Monotoba/j48-gal-programmer/wingman/README.md

# Wingman

Host software for the J48 Programmer: reads and writes JEDEC (.jed) files and drives the programmer over USB. Not started.

Written clean-room from `docs/spec/`; see `docs/CLEAN_ROOM.md`.
