Monotoba/j48-gal-programmer/docs/spec/16v8.md

# GAL16V8 programming specification

Covers the GAL16V8 family (Lattice GAL16V8, 16V8A/B/D and second sources) and notes where the Atmel ATF16V8B differs. Written from published sources only; see [CLEAN_ROOM.md](../CLEAN_ROOM.md). Facts carry a source tag; anything not yet sourced is listed under **Open questions**, not guessed.

## Sources

| Tag | Source |
| --- | --- |
| [D1] | Lattice Semiconductor, *GAL16V8 High Performance E²CMOS PLD* datasheet, https://www.cl.cam.ac.uk/teaching/0708/Hardware/datasheets/gal16v8.pdf |
| [G1] | GALer documentation, "Programming GALs" (§III.1), https://k1.spdns.de/Develop/Projects/GalAsm/info/galer/proggal.html |
| [G2] | GALer documentation, "The GAL16V8 and GAL20V8", https://k1.spdns.de/Develop/Projects/GalAsm/info/galer/gal16_20v8.html |
| [G3] | GALer documentation, "JEDEC File", https://k1.spdns.de/Develop/Projects/GalAsm/info/galer/jedecfile.html |
| [A1] | Bruce Abbott, "Parallel Port ATF and GAL Programmer" (project page, prose only), https://www.bhabbott.net.nz/atfblast.html |
| [J] | [jedec.md](jedec.md) for the JEDEC file format and checksum |

## Device summary

- 20-pin device: pins 2–9 inputs, pin 1 input or clock, pin 11 input or /OE, pins 12–19 output cells (OLMCs), pin 10 GND, pin 20 VCC. [G2]
- AND array of 64 product terms × 32 input lines = 2,048 fuses. Each OLMC owns 8 product terms (a 256-fuse block); the 8th can serve as the output-enable term. [D1]
- Operating modes, set by SYN, AC0 and each OLMC's AC1 (XOR sets polarity: 0 = active low, 1 = active high): [D1][G2]

| Mode | SYN | AC0 | AC1(n) = 0 | AC1(n) = 1 |
| --- | --- | --- | --- | --- |
| Simple | 1 | 0 | combinational output | dedicated input |
| Complex | 1 | 1 | — | combinational I/O (tristate) |
| Registered | 0 | 1 | registered output | combinational I/O |

- Endurance 100 erase/write cycles, data retention 20 years, erase time under 100 ms. [D1]

## JEDEC fuse map (QF2194)

| Fuses | Contents | Source |
| --- | --- | --- |
| 0–2047 | AND array: product term *n* starts at fuse 32 × *n* | [D1][G3] |
| 2048–2055 | XOR bits, one per OLMC | [D1][G3] |
| 2056–2119 | User Electronic Signature (UES), 64 bits | [G3] |
| 2120–2127 | AC1 bits, one per OLMC | [D1][G3] |
| 2128–2191 | Product-term disable (PTD) bits, one per product term | [D1][G3] |
| 2192 | SYN | [D1][G3] |
| 2193 | AC0 | [D1][G3] |

The UES is readable even when the security cell is set, and it is included in the checksum. [D1]

## Programming-mode pins

The device enters edit mode when 12.00–16.5 V is applied to pin 2 (EDIT), with VCC at 5 V. Pins not listed must be held low. [G1]

| Chip pin | Role | Notes | ZIF-28 | J48 Rev H net (driver) |
| --- | --- | --- | --- | --- |
| 2 | EDIT | edit-mode supply | 2 | VPP (VPP generator) |
| 3 | RA1 | row address | 3 | U1 PD0 (MCU) |
| 4 | RA2 | row address | 4 | U2 Q0 (595) |
| 5 | RA3 | row address | 5 | U2 Q3 (595) |
| 6 | RA4 | row address | 6 | U2 Q2 (595) |
| 7 | RA5 | row address | 7 | U2 Q1 via R43 (595) |
| 8 | SCLK | serial clock, data shifts on the rising edge | 8 | U1 PD2 (MCU) |
| 9 | SDIN | serial data in | 9 | U1 PD3 (MCU) |
| 10 | GND | | 10 | Q1 ground switch |
| 11 | /STR | strobe, active low | 19 | U1 PC3 (MCU) |
| 12 | SDOUT | serial data out | 20 | U1 PF0 (MCU) |
| 18 | RA0 | row address | 26 | U1 PF1 (MCU) |
| 19 | P/V | high = program (write), low = verify (read) | 27 | U2 Q7 (595) |
| 20 | VCC | 5 V | 28 | Q6 VCC switch |
| 1, 13–17 | held low | | 1, 21–25 | pull-downs (1, 21–23); U2 Q5, Q4 driven low (24, 25) |

Pin roles from [G1]; the same roles appear in the Afterburner pin map, an independent source. ZIF and net columns are J48 Rev H (`hardware/drawings/J48_ZIF28_Pin_Map_RevH.pdf`).

## Row map

Rows are selected with RA0–RA5 (row 0–63). [G1]

| Row | Width | Contents | Source |
| --- | --- | --- | --- |
| 0–31 | 64 bits | AND-array fuses | [G1] |
| 32 | 64 bits | User Electronic Signature | [G1] |
| 33–59 | 64 bits | reserved | [G1] |
| 60 | 82 bits | Architecture Control Word (ACW) | [G1] |
| 61 | — | security bit | [G1] |
| 62 | — | reserved | [G1] |
| 63 | — | bulk erase | [G1] |

**ACW bit order (row 60), GAL16V8A/B:** bits 0–3 XOR, bit 4 AC0, bits 5–8 AC1, bits 9–72 PT0–PT63 (product-term enables), bits 73–76 AC1, bit 77 SYN, bits 78–81 XOR. The original GAL16V8 (no suffix) uses a different order. [G1]

## Sequences

**Read a row:** set P/V low; put the row address on RA0–RA5; pulse /STR low to load the row into the device's shift register; then give one rising edge on SCLK per bit, reading SDOUT for each. [G1]

**Write a row:** set P/V high; put the row address on RA0–RA5; shift the row's bits in on SDIN, one rising SCLK edge per bit; pulse /STR low for the programming pulse width (table below). [G1]

**Bulk erase:** set P/V high, select row 63, pulse /STR low for 100 ms, then set P/V low. [G1]

**Programming flow (J48):**
1. With the socket unpowered, select the 20-pin configuration: Q1 (ZIF 10 GND) and Q6 (ZIF 28 VCC). See the Rev H switch table.
2. Apply VCC, hold all non-programming pins low, then raise EDIT to the read level.
3. Identify the device and its algorithm (see Open questions), then bulk erase at the programming level.
4. Write rows 0–31, the UES (row 32) and the ACW (row 60) at the programming level and pulse width.
5. Drop to the read level and read every row back to verify.
6. If the JEDEC file has `G1`, set the security bit (row 61).
7. Lower EDIT to 0 V before removing VCC.

## Voltages and pulse widths by algorithm

| Algorithm | Read EDIT level | Read /STR pulse | Program EDIT level | Program /STR pulse |
| --- | --- | --- | --- | --- |
| 0 | 12.00 ± 0.25 V | 5 µs | 15.75 ± 0.25 V | 80 ± 5 ms |
| 1 | 12.00 ± 0.25 V | 5 µs | 15.75 ± 0.25 V | 80 ± 5 ms |
| 2 | 12.00 ± 0.25 V | 5 µs | 16.50 ± 0.25 V | 10 ± 1 ms |
| 3 | 12.00 ± 0.25 V | 5 µs | 14.50 ± 0.25 V | 40 ± 5 ms |
| 4 | 12.00 ± 0.25 V | 5 µs | 14.00 ± 0.25 V | 100 ± 5 ms |

Source: [G1]. The J48's VPP generator covers this range: 0–17.4 V, about 4.25 mV per DAC step.

## Atmel ATF16V8B differences

- The ATF electronic signature does not encode programming parameters; it holds the part number as byte-reversed text (for example "1F16V8B1" for an ATF16V8B). Interpreting it as a GAL signature selects the wrong algorithm. [A1]
- Atmel parts should be conditioned before programming: program all cells to 0 twice, then erase. Verify errors during conditioning can be ignored. [A1]
- ATF parts have input pull-ups or pin keepers; most Lattice GAL16V8/16V8B parts do not. [A1]
- Programming voltage requirement for ATF parts: see Open questions.

## Open questions

Each needs a published source before firmware depends on it.

- [ ] **Signature row and algorithm code:** which row holds the programmer electronic signature (PES), its width, and how its bytes encode manufacturer, algorithm, EDIT voltage and pulse width.
- [ ] **Row-to-fuse mapping:** how programming rows 0–31 (64 bits each) map onto the JEDEC array (64 product terms × 32 inputs), including whether the input-line order is linear.
- [ ] **Bit order:** which bit is shifted first when writing and reading a row, and how ACW bits map onto JEDEC fuses 2048–2193.
- [ ] **Original GAL16V8 ACW order** (no-suffix parts), which [G1] says differs from the A/B order.
- [ ] **Security bit (row 61):** the exact write sequence.
- [ ] **Timing:** SCLK high/low times, setup and hold of SDIN and RA lines, settling time after changing EDIT level, delay after /STR before reading.
- [ ] **ATF16V8B:** its programming EDIT voltage, pulse widths and erase sequence.
- [ ] **JEDEC checksum detail:** see [jedec.md](jedec.md).
