Monotoba/j48-gal-programmer/docs/pin-map/J48_RevH_ZIF28_Plan.xlsx

Sheet: 26CV12 Changes
GAL26CV12 / 26V12 head-aligned in a ZIF-28: what each position needs (proposed Rev H)
Shaded rows need hardware changes. ZIF numbers are for the proposed ZIF-28; Rev G ZIF 13–24 become ZIF 17–28.
ZIF (Rev H) | 26CV12 needs | Rev G has there | Change
2 | EDIT (VPP) | VPP | None
3 | PV | U1 PD0 | None
4, 5, 6 | RA0–RA2 | U2 Q0, Q3, Q2 | None
7 | VCC | U2 Q1 (RA3 for 22V10) | High-side P-FET from VCC_SKT, plus 100 Ω in series with U2 Q1
8 | Low | U1 PD2 | None
9, 10, 11 | RA3–RA5 | U1 PD3, PD4, PD5 | None
12 | SCLK | Hard GND (24-pin GND) | Ground-switch FET for 24-pin parts, plus a driver through 100 Ω
13, 14 | SDIN, STB | New position | Drivers
15 | SDOUT | New position | Must be an MCU input
16–20 | Low | New pull-down, then MCU lines | None (firmware drives them low)
21 | GND | Pull-down only | Ground-switch FET
22–27 | Low | Pull-downs, 595, MCU | None
28 | Low | VCC_SKT, always on | High-side P-FET for 20/24-pin parts, plus a pull-down
Source: 26CV12 programming pinout from the EMDP1 GAL28 plug table, gramlich.net/projects/extensible_programmer/emdp1/plugs/gal28/rev_a/ (cross-check against Afterburner's 26CV12 adapter files).

Sheet: ZIF-28 Map
ZIF-28 socket map, all devices head-aligned (proposed Rev H)
Orange rows change in Rev H; green rows are new socket positions. Chip-pin columns are formulas from the ZIF number (head alignment).
ZIF (Rev H) | Side | Rev G ZIF | Rev G connection | Rev H connection | Changed? | 20-pin chip pin | 16V8 | 18V10 | 24-pin chip pin | 22V10 / 20XV10 / ATF750C | 20V8 | 6001 / 6002 | JTAG ATF150x | 28-pin chip pin | 26CV12 / 26V12
1 | left (1–14) | 1 | Pull-down R20 10k | Pull-down R20 10k (unchanged) | No | 1 | - | - | 1 | - | - | - | - | 1 | low
2 | left (1–14) | 2 | VPP | VPP (unchanged) | No | 2 | EDIT | EDIT | 2 | EDIT | EDIT | EDIT | EDIT | 2 | EDIT
3 | left (1–14) | 3 | U1 PD0 (via R2) | U1 PD0 (via R2) (unchanged) | No | 3 | RA1 | RA3 | 3 | PV | RA1 | - | TDI | 3 | PV
4 | left (1–14) | 4 | U2 Q0 | U2 Q0 (unchanged) | No | 4 | RA2 | RA4 | 4 | RA0 | RA2 | RA0 | - | 4 | RA0
5 | left (1–14) | 5 | U2 Q3 | U2 Q3 (unchanged) | No | 5 | RA3 | RA5 | 5 | RA1 | RA3 | RA1 | - | 5 | RA1
6 | left (1–14) | 6 | U2 Q2 | U2 Q2 (unchanged) | No | 6 | RA4 | SCLK | 6 | RA2 | - | RA2 | - | 6 | RA2
7 | left (1–14) | 7 | U2 Q1 | U2 Q1 via new 100 Ω + Q7 P-FET from VCC_SKT (VCC for 28-pin) | Yes | 7 | RA5 | DIN | 7 | RA3 | - | RA3 | - | 7 | VCC
8 | left (1–14) | 8 | U1 PD2 (via R3) | U1 PD2 (via R3) (unchanged) | No | 8 | SCLK | STR | 8 | RA4 | RA4 | RA4 | - | 8 | low
9 | left (1–14) | 9 | U1 PD3 (via R4) | U1 PD3 (via R4) (unchanged) | No | 9 | DIN | DOUT | 9 | RA5 | RA5 | RA5 | - | 9 | RA3
10 | left (1–14) | 10 | U1 PD4 (via R5) + Q1 ground switch | U1 PD4 (via R5) + Q1 ground switch (unchanged) | No | 10 | GND | GND | 10 | SCLK | SCLK | SCLK | - | 10 | RA4
11 | left (1–14) | 11 | U1 PD5 (via R6) | U1 PD5 (via R6) (unchanged) | No | — | (no chip pin) | (no chip pin) | 11 | DIN | DIN | DIN | - | 11 | RA5
12 | left (1–14) | 12 | GND (hard) | U9 Q0 via 100 Ω (SCLK) + Q4 ground switch (GND for 24-pin) | Yes | — | (no chip pin) | (no chip pin) | 12 | GND | GND | GND | GND | 12 | SCLK
13 | left (1–14) | new | — (new position) | U9 Q1 (SDIN) | Yes | — | (no chip pin) | (no chip pin) | — | (no chip pin) | (no chip pin) | (no chip pin) | (no chip pin) | 13 | SDIN
14 | left (1–14) | new | — (new position) | U9 Q2 (STB) | Yes | — | (no chip pin) | (no chip pin) | — | (no chip pin) | (no chip pin) | (no chip pin) | (no chip pin) | 14 | STB
15 | right (15–28) | new | — (new position) | U1 PA3 via 100 Ω (SDOUT); PA3 was BOOST_EN | Yes | — | (no chip pin) | (no chip pin) | — | (no chip pin) | (no chip pin) | (no chip pin) | (no chip pin) | 15 | SDOUT
16 | right (15–28) | new | — (new position) | Pull-down 10k (new) | Yes | — | (no chip pin) | (no chip pin) | — | (no chip pin) | (no chip pin) | (no chip pin) | (no chip pin) | 16 | low
17 | right (15–28) | 13 | U1 PD6 (via R7) | U1 PD6 (via R7) (unchanged) | No | — | (no chip pin) | (no chip pin) | 13 | STR | STR | STR | TMS | 17 | low
18 | right (15–28) | 14 | U1 PD7 (via R8) | U1 PD7 (via R8) (unchanged) | No | — | (no chip pin) | (no chip pin) | 14 | DOUT | - | DOUT | - | 18 | low
19 | right (15–28) | 15 | U1 PC3 (via R1) | U1 PC3 (via R1) (unchanged) | No | 11 | STR | - | 15 | - | DOUT | - | - | 19 | low
20 | right (15–28) | 16 | U1 PF0 (via R9) | U1 PF0 (via R9) (unchanged) | No | 12 | DOUT | - | 16 | - | - | - | - | 20 | low
21 | right (15–28) | 17 | Pull-down R21 10k | Pull-down R21 10k + Q5 ground switch (GND for 28-pin) | Yes | 13 | - | - | 17 | - | - | - | - | 21 | GND
22 | right (15–28) | 18 | Pull-down R22 10k | Pull-down R22 10k (unchanged) | No | 14 | - | - | 18 | - | - | - | - | 22 | low
23 | right (15–28) | 19 | Pull-down R23 10k | Pull-down R23 10k (unchanged) | No | 15 | - | - | 19 | - | - | - | - | 23 | low
24 | right (15–28) | 20 | U2 Q5 | U2 Q5 (unchanged) | No | 16 | - | RA2 | 20 | - | - | - | - | 24 | low
25 | right (15–28) | 21 | U2 Q4 | U2 Q4 (unchanged) | No | 17 | - | RA1 | 21 | - | RA0 | - | - | 25 | low
26 | right (15–28) | 22 | U1 PF1 (via R10) | U1 PF1 (via R10) (unchanged) | No | 18 | RA0 | RA0 | 22 | - | PV | - | TDO | 26 | low
27 | right (15–28) | 23 | U2 Q7 | U2 Q7 (unchanged) | No | 19 | PV | PV | 23 | - | - | PV | TCK | 27 | low
28 | right (15–28) | 24 | VCC_SKT (always on) | VCC_SKT via Q6 P-FET (VCC for 20/24-pin) + pull-down 10k | Yes | 20 | VCC | VCC | 24 | VCC | VCC | VCC | VCC | 28 | low
Role names: EDIT = VPP pin in edit mode, PV = program/verify, RA0–RA5 = row address, SCLK = serial clock, DIN/SDIN = serial data in,
STR/STB = strobe, DOUT/SDOUT = serial data out, '-' / 'low' = held low or undriven. Afterburner names are used for the 20/24-pin columns.
Source: Afterburner rev 3.2b schematic, 'ZIF SOCKET PIN MAP' (ole00), as uploaded.
Source: 26CV12 programming pinout from the EMDP1 GAL28 plug table, gramlich.net/projects/extensible_programmer/emdp1/plugs/gal28/rev_a/ (cross-check against Afterburner's 26CV12 adapter files).
Positions changed in Rev H |  |  |  | 8
New positions (no Rev G equivalent) |  |  |  | 4

Sheet: U9 595 Outputs
U9: second 74HC595, chained from U2 Q7' (proposed Rev H)
U9 shares SPI_SCK, SR_RCLK and SR_OE with U2; its SER (pin 14) comes from U2 Q7' (pin 9). Each update shifts 2 bytes, U9 first.
Output | U9 pin | Net | Drives | Used for | Active level | State at reset
Q0 | 15 | ZIF12_SCLK | ZIF 12 via 100 Ω | 26CV12 SCLK; held low in 24-pin mode (Q4 grounds ZIF 12) | High = 1 | Hi-Z (/OE high)
Q1 | 1 | ZIF13_SDIN | ZIF 13 | 26CV12 SDIN | High = 1 | Hi-Z (/OE high)
Q2 | 2 | ZIF14_STB | ZIF 14 | 26CV12 STB (active low) | High = 1 | Hi-Z (/OE high)
Q3 | 3 | BOOST_EN | U4 EN (was U1 PA3) | Boost on; R36 pull-down keeps it off at reset | High = on | Off (R36)
Q4 | 4 | GND12_EN | Q4 gate (N-FET, ZIF 12 to GND) | 24-pin parts only | High = grounded | Off (gate pull-down)
Q5 | 5 | GND21_EN | Q5 gate (N-FET, ZIF 21 to GND) | 28-pin parts only | High = grounded | Off (gate pull-down)
Q6 | 6 | VCC28_EN | Q6 gate (P-FET, VCC_SKT to ZIF 28) | 20- and 24-pin parts | Low = VCC on | Off (gate pull-up)
Q7 | 7 | VCC7_EN | Q7 gate (P-FET, VCC_SKT to ZIF 7) | 28-pin parts only | Low = VCC on | Off (gate pull-up)
Q7' | 9 | — | Not connected | End of chain | — | —
Freed MCU pin |  | U1 PA3 (pin 1): was BOOST_EN, becomes SDOUT input from ZIF 15 via 100 Ω.
Note |  | SCLK and SDIN through a 595 cost a few µs per bit; the 26CV12's ~10 ms per-row programming pulse dominates.

Sheet: Socket Power Modes
Ground and VCC switch settings by device size (proposed Rev H)
Firmware interlock: exactly one GND switch and one VCC switch on at a time, chosen by device size. Never Q6 with Q7, never Q4 with a 28-pin part.
Device size | Q1: ZIF 10 GND (595 U2 Q6) | Q4: ZIF 12 GND (U9 Q4) | Q5: ZIF 21 GND (U9 Q5) | Q6: ZIF 28 VCC (U9 Q6) | Q7: ZIF 7 VCC (U9 Q7) | Notes | GND switches on | VCC switches on
No device / reset | Off | Off | Off | Off | Off | All outputs Hi-Z; socket unpowered until firmware selects a size | 0 | 0
20-pin (16V8, 18V10) | On | Off | Off | On | Off | Chip GND on ZIF 10, VCC on ZIF 28 | 1 | 1
24-pin (22V10, 20V8, 6001/6002, ATF750C, JTAG adapter) | Off | On | Off | On | Off | Chip GND on ZIF 12, VCC on ZIF 28; U9 Q0 must be low | 1 | 1
28-pin (26CV12, 26V12) | Off | Off | On | Off | On | Chip GND on ZIF 21, VCC on ZIF 7; ZIF 28 held low by its pull-down; U2 Q1 set high | 1 | 1

Sheet: Rev H Parts
Rev H parts added or changed (proposed)
Reference designators continue from Rev G (last: Q3, R36, C18, U8, J4). Values are proposals to confirm.
Ref | Part / value | Qty | Purpose | Add / change
J1 | ZIF-28 socket, accepts 0.3" and 0.6" DIP | 1 | Replaces the ZIF-24 | Change
U9 | 74HC595 | 1 | Second shift register, chained from U2 Q7' | Add
C19 | 100n | 1 | U9 decoupling, VSYS | Add
Q4, Q5 | AO3400 N-FET (logic level) | 2 | Ground switches on ZIF 12 and ZIF 21 | Add
Q6, Q7 | AO3401 P-FET (logic level) | 2 | VCC switches on ZIF 28 and ZIF 7 | Add
R37, R38 | 100 Ω | 2 | Gate resistors for Q4, Q5 | Add
R39, R40 | 100k | 2 | Gate pull-downs for Q4, Q5 (off at reset) | Add
R41, R42 | 100k | 2 | Gate pull-ups to VCC_SKT for Q6, Q7 (off at reset) | Add
R43 | 100 Ω | 1 | U2 Q1 to ZIF 7 series resistor | Add
R44 | 100 Ω | 1 | U9 Q0 to ZIF 12 series resistor | Add
R45 | 100 Ω | 1 | U1 PA3 to ZIF 15 series resistor | Add
R46, R47 | 10k | 2 | Pull-downs on ZIF 16 and ZIF 28 | Add
 | Total parts | 18
 | Resistors added | 11

Sheet: Notes
Behaviour changes and open items (proposed Rev H)
Socket powers up dead | With U9's outputs off at reset, every VCC and GND switch is off. Firmware selects the device size before the chip gets power. 24-pin parts now need firmware to ground ZIF 12 (it was hard ground in Rev G).
Interlocks | Never turn on the ZIF 7 and ZIF 28 supplies together, and never ground ZIF 12 with a 28-pin part in the socket: those contacts carry signals for the other sizes.
Existing devices | Rev G ZIF 13–24 wiring keeps its nets and moves to ZIF 17–28, so 20- and 24-pin parts and the JTAG adapter see the same signals as before.
Firmware | The 26CV12 algorithm is close to the 22V10's with a different fuse-map geometry. Afterburner supports GAL26CV12B and GAL26V12C through an adapter, so this is a port.
Verify pinout | Cross-check the 26CV12 programming pinout against Afterburner's 26CV12 adapter files before committing (VCC pin 7, GND pin 21).
Socket width | The 26CV12 DIP is the 0.3" skinny package: choose a ZIF-28 that takes both 0.3" and 0.6" parts.
Speed | SCLK and SDIN through U9 cost a few µs per bit, small next to the ~10 ms per-row programming pulse. Rev F already clocks the 18V10 through a 595 (ZIF 6).
Sources | Source: Afterburner rev 3.2b schematic, 'ZIF SOCKET PIN MAP' (ole00), as uploaded. Source: 26CV12 programming pinout from the EMDP1 GAL28 plug table, gramlich.net/projects/extensible_programmer/emdp1/plugs/gal28/rev_a/ (cross-check against Afterburner's 26CV12 adapter files). Afterburner supported-chip list: github.com/ole00/afterburner.
