Monotoba/j48-gal-programmer/hardware/kicad/J48_RevI.kicad_sch

## KiCad design hardware/kicad/J48_RevI.kicad_sch (2026-10-22)

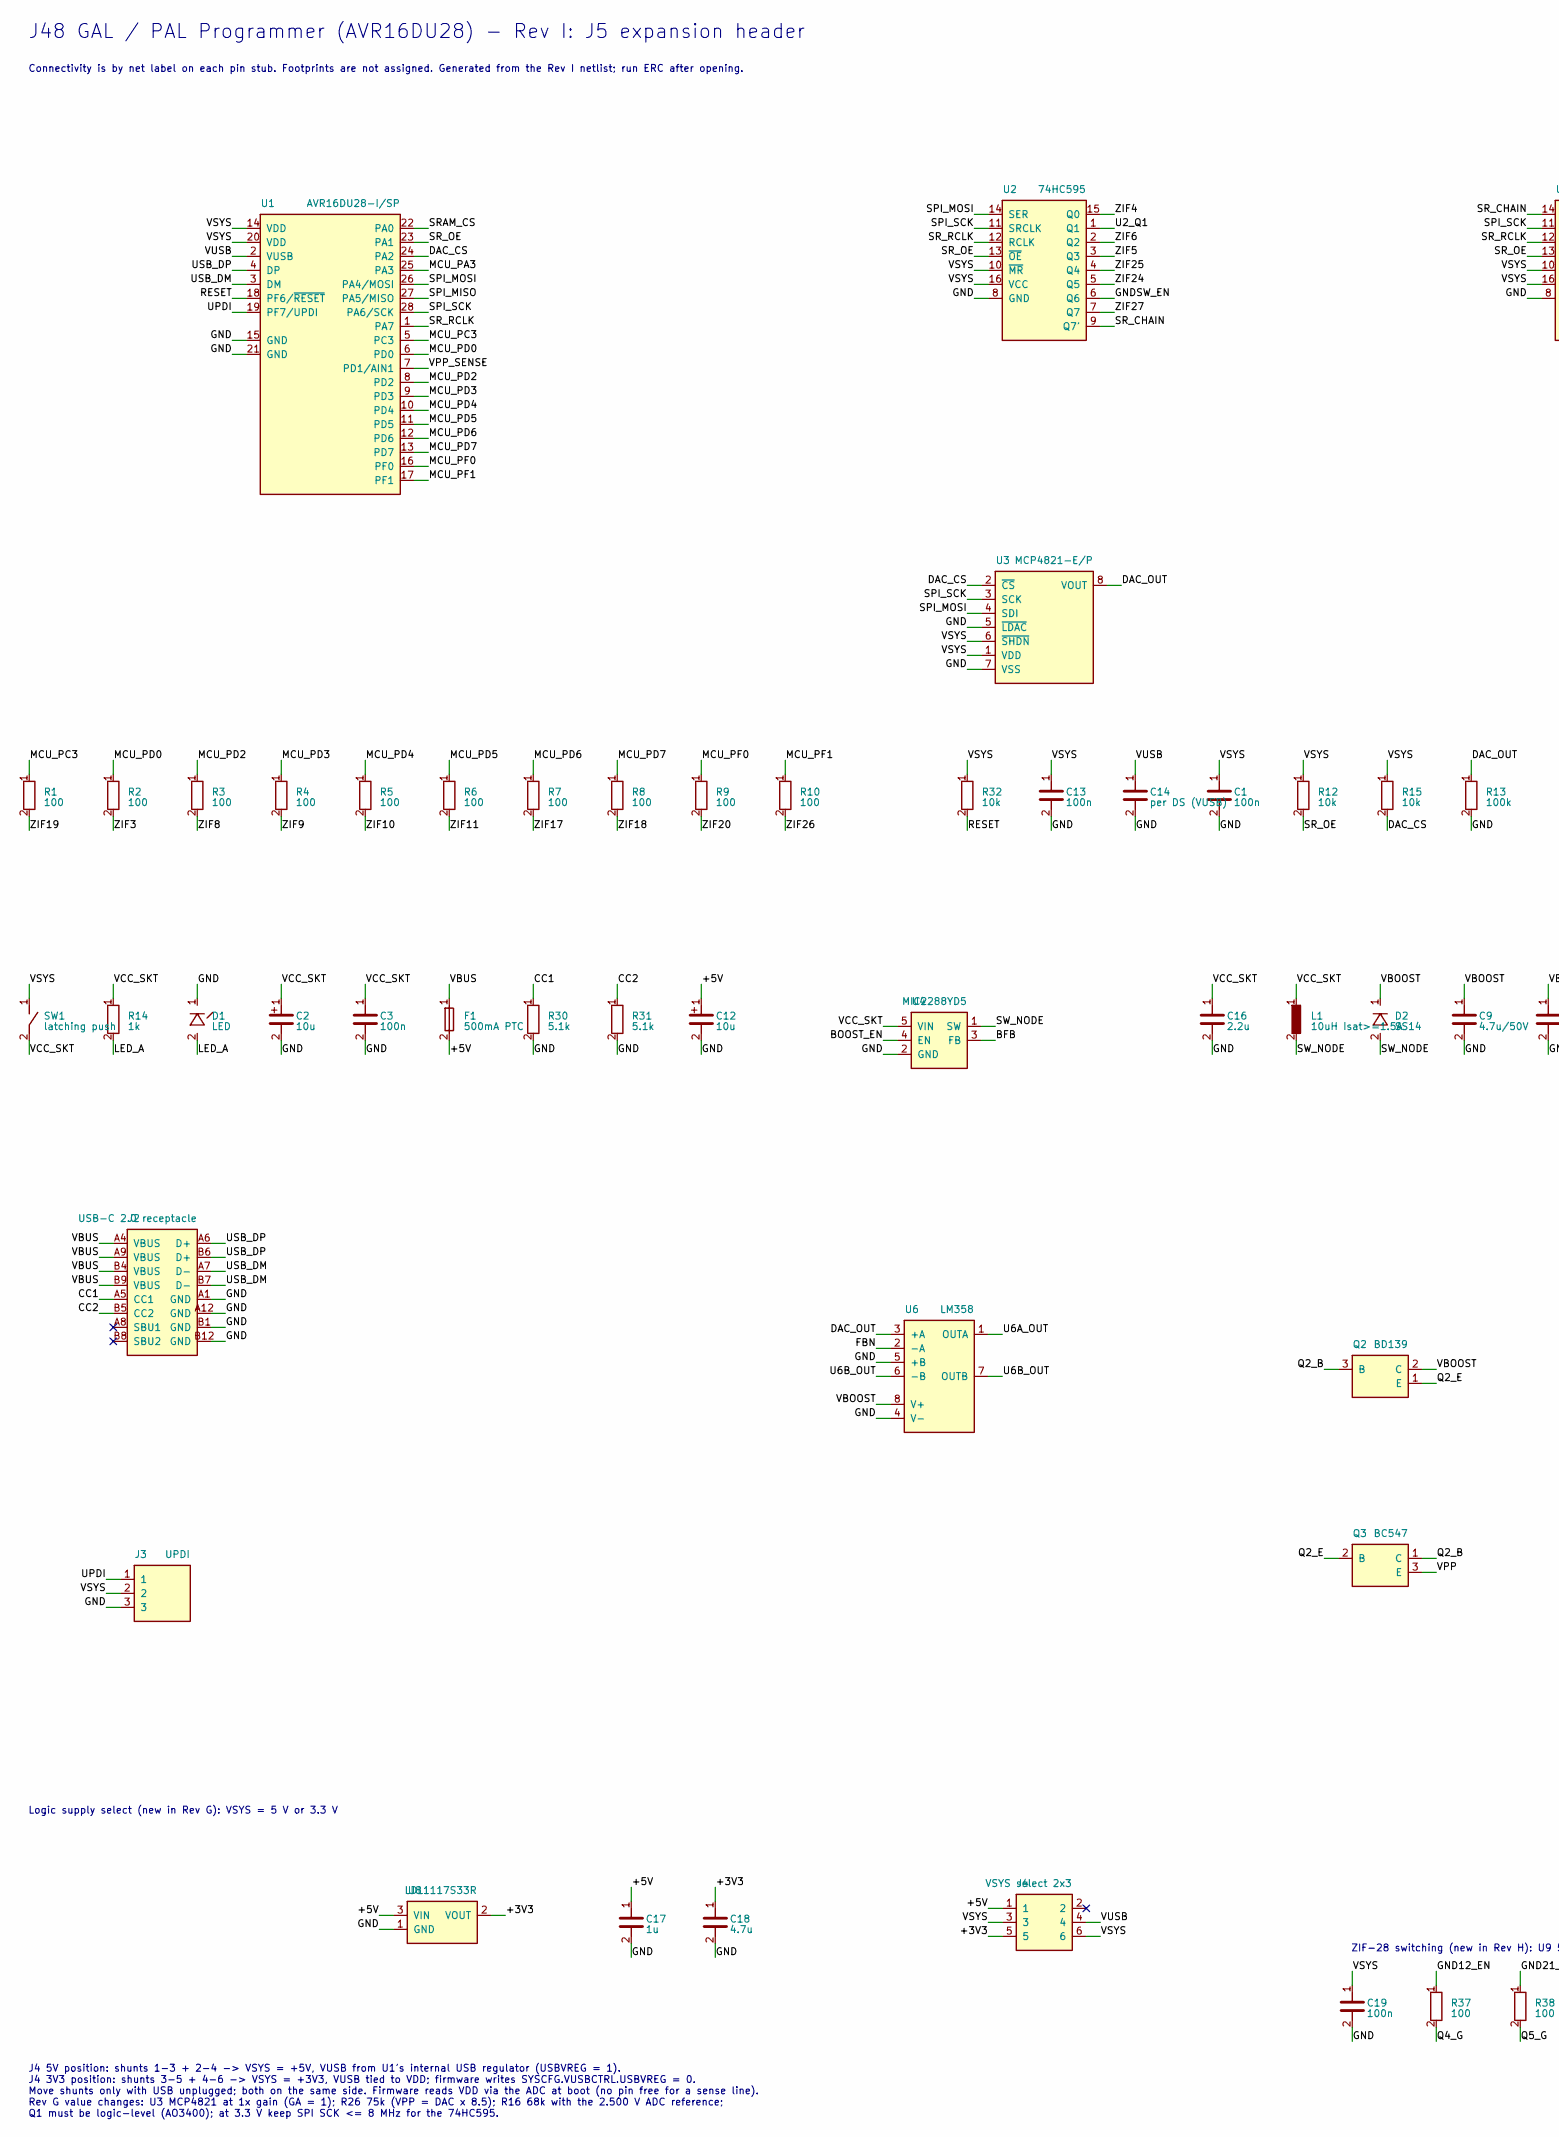
[picture p6: schematic J48_RevI.kicad_sch, part in row 1, column 1]

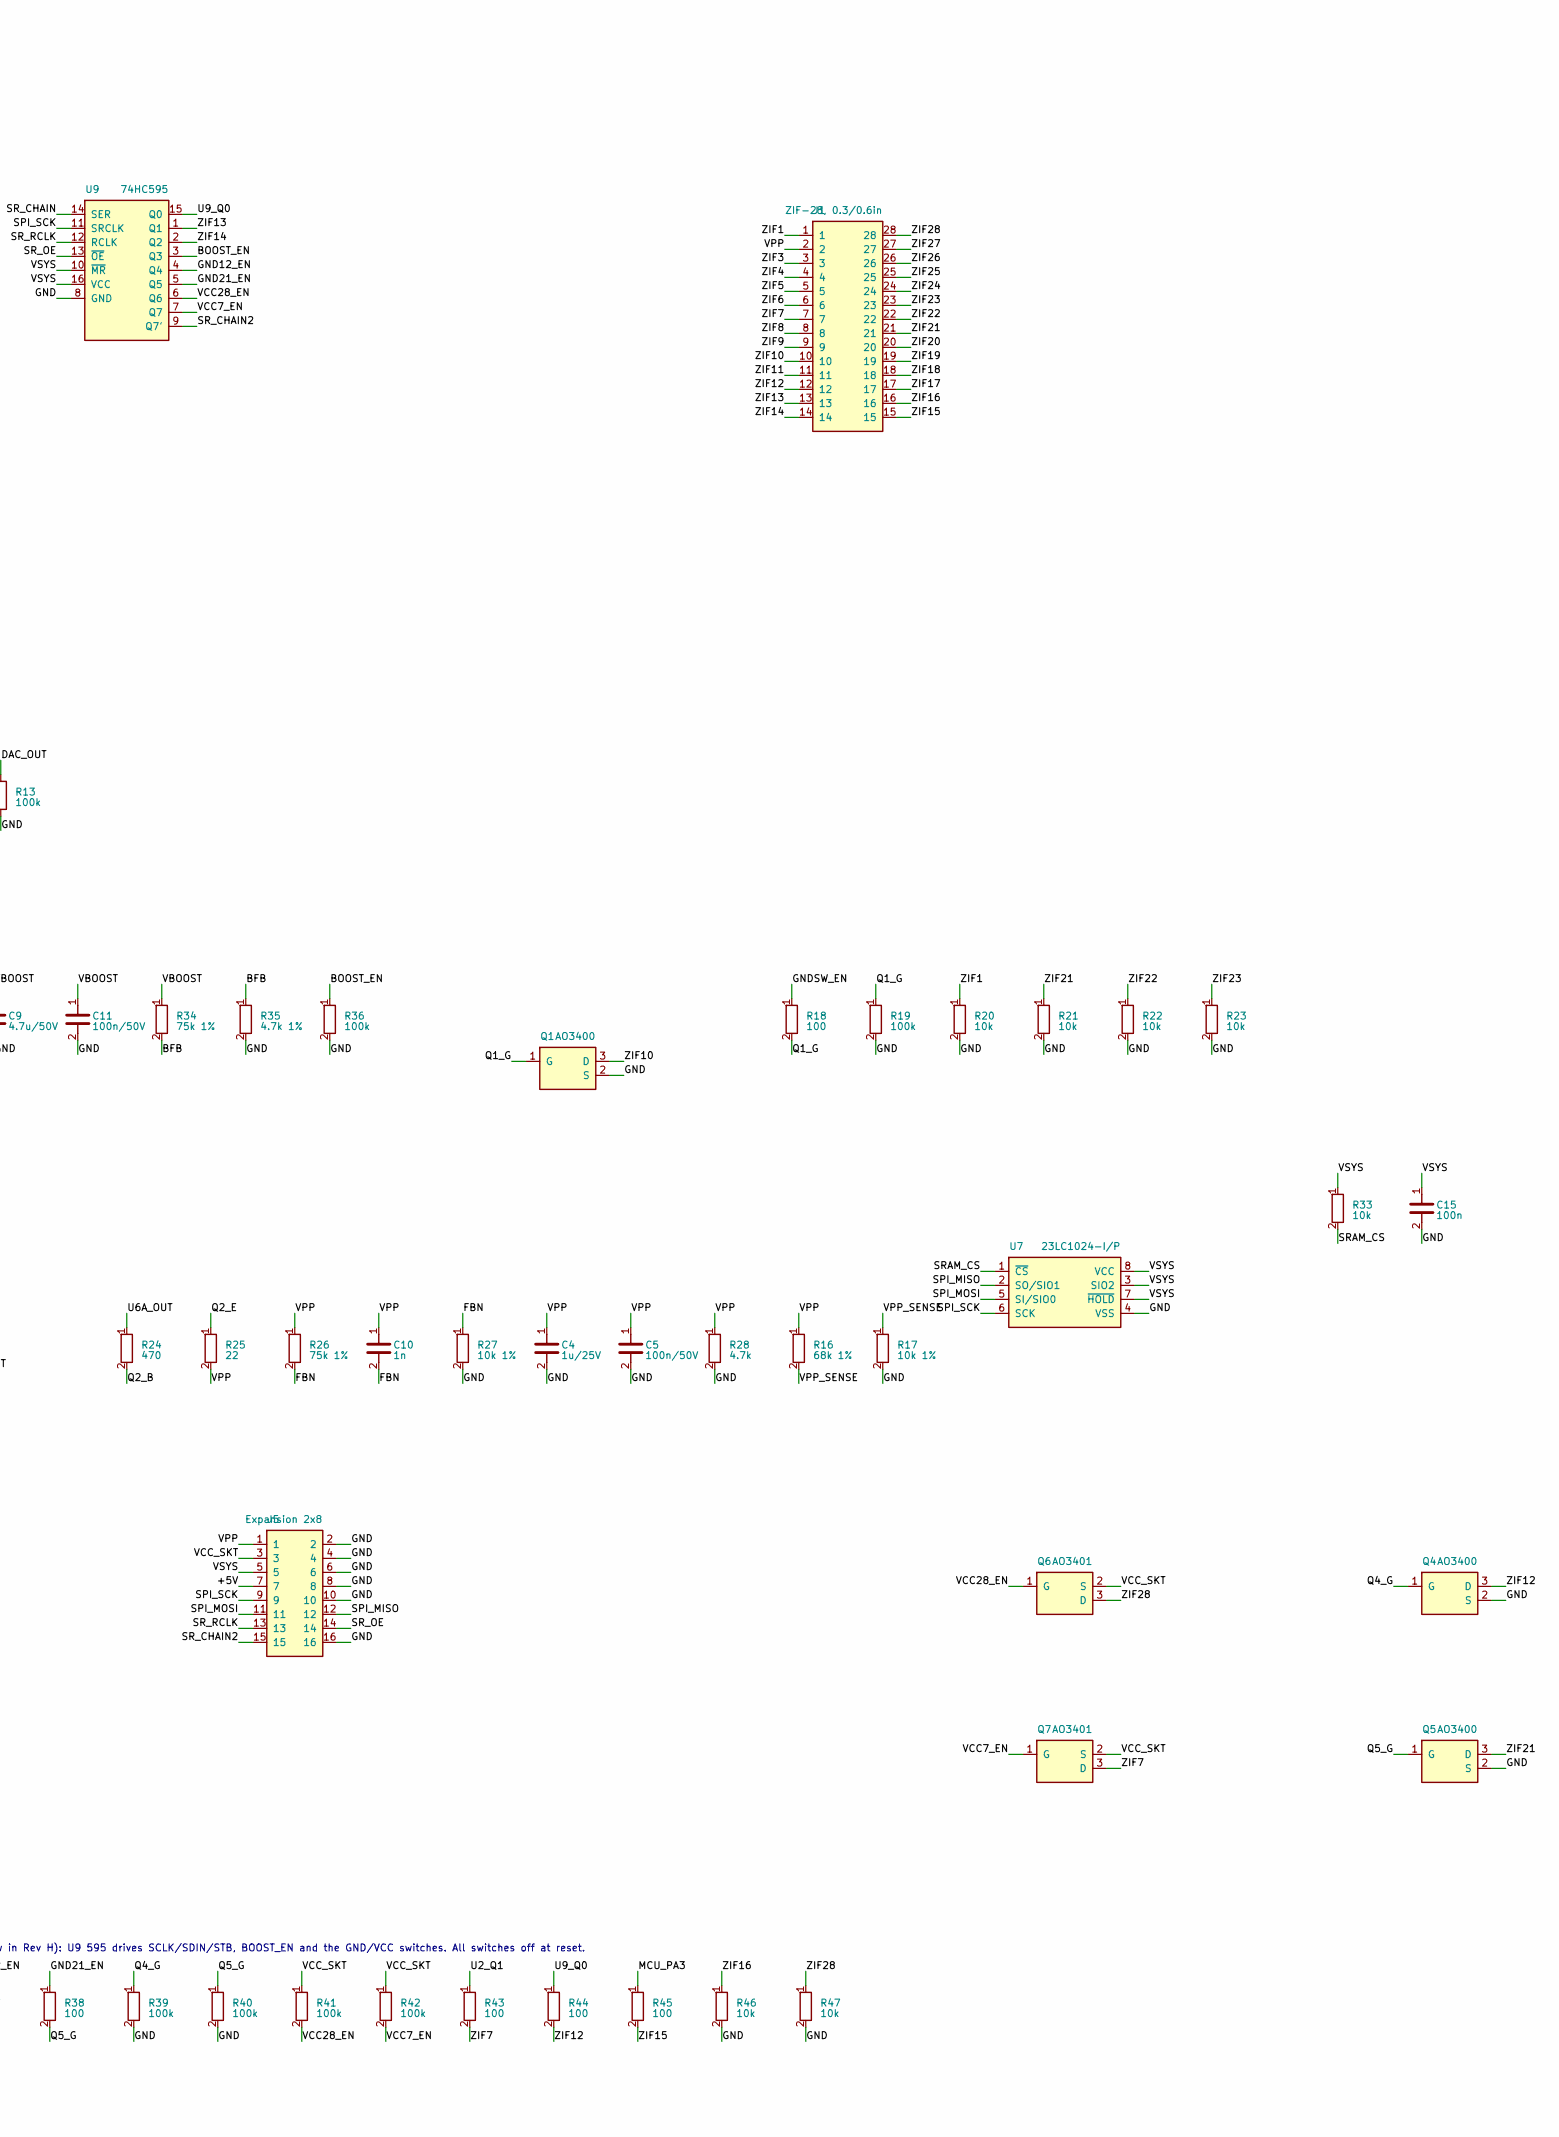
[picture p7: schematic J48_RevI.kicad_sch, part in row 1, column 2]

Parts:
C1, C3, C13, C15, C19: 100n
C2, C12: 10u
C4: 1u/25V
C5, C11: 100n/50V
C9: 4.7u/50V
C10: 1n
C14: per DS (VUSB)
C16: 2.2u
C17: 1u
C18: 4.7u
D1: LED
D2: SS14
F1: 500mA PTC
J1: ZIF-28, 0.3/0.6in
J2: USB-C 2.0 receptacle
J3: UPDI
J4: VSYS select 2x3
J5: Expansion 2x8
L1: 10uH Isat>=1.5A
Q1, Q4, Q5: AO3400
Q2: BD139
Q3: BC547
Q6, Q7: AO3401
R1, R2, R3, R4, R5, R6, R7, R8, R9, R10, R18, R37, R38, R43, R44, R45: 100
R12, R15, R20, R21, R22, R23, R32, R33, R46, R47: 10k
R13, R19, R36, R39, R40, R41, R42: 100k
R14: 1k
R16: 68k 1%
R17, R27: 10k 1%
R24: 470
R25: 22
R26, R34: 75k 1%
R28: 4.7k
R30, R31: 5.1k
R35: 4.7k 1%
SW1: latching push
U1: AVR16DU28-I/SP
U2, U9: 74HC595
U3: MCP4821-E/P
U4: MIC2288YD5
U6: LM358
U7: 23LC1024-I/P
U8: LDL1117S33R

Connections:
+3V3: C18.1, J4.5, U8.2 (VOUT)
+5V: C12.1, C17.1, F1.2, J4.1, J5.7, U8.3 (VIN)
BFB: R34.2, R35.1, U4.3 (FB)
BOOST_EN: R36.1, U4.4 (EN), U9.3 (Q3)
CC1: J2.A5 (CC1), R30.1
CC2: J2.B5 (CC2), R31.1
DAC_CS: R15.2, U1.24 (PA2), U3.2 (~CS)
DAC_OUT: R13.1, U3.8 (VOUT), U6.3 (+A)
FBN: C10.2, R26.2, R27.1, U6.2 (-A)
GND: C1.2, C2.2, C3.2, C4.2, C5.2, C9.2, C11.2, C12.2, C13.2, C14.2, C15.2, C16.2, C17.2, C18.2, C19.2, D1.1 (K), J2.A1 (GND), J2.A12 (GND), J2.B1 (GND), J2.B12 (GND), J3.3, J5.2, J5.4, J5.6, J5.8, J5.10, J5.16, Q1.2 (S), Q4.2 (S), Q5.2 (S), R13.2, R17.2, R19.2, R20.2, R21.2, R22.2, R23.2, R27.2, R28.2, R30.2, R31.2, R35.2, R36.2, R39.2, R40.2, R46.2, R47.2, U1.15 (GND), U1.21 (GND), U2.8 (GND), U3.5 (~LDAC), U3.7 (VSS), U4.2 (GND), U6.4 (V-), U6.5 (+B), U7.4 (VSS), U8.1 (GND), U9.8 (GND)
GND12_EN: R37.1, U9.4 (Q4)
GND21_EN: R38.1, U9.5 (Q5)
GNDSW_EN: R18.1, U2.6 (Q6)
LED_A: D1.2 (A), R14.2
MCU_PA3: R45.1, U1.25 (PA3)
MCU_PC3: R1.1, U1.5 (PC3)
MCU_PD0: R2.1, U1.6 (PD0)
MCU_PD2: R3.1, U1.8 (PD2)
MCU_PD3: R4.1, U1.9 (PD3)
MCU_PD4: R5.1, U1.10 (PD4)
MCU_PD5: R6.1, U1.11 (PD5)
MCU_PD6: R7.1, U1.12 (PD6)
MCU_PD7: R8.1, U1.13 (PD7)
MCU_PF0: R9.1, U1.16 (PF0)
MCU_PF1: R10.1, U1.17 (PF1)
Q1_G: Q1.1 (G), R18.2, R19.1
Q2_B: Q2.3 (B), Q3.1 (C), R24.2
Q2_E: Q2.1 (E), Q3.2 (B), R25.1
Q4_G: Q4.1 (G), R37.2, R39.1
Q5_G: Q5.1 (G), R38.2, R40.1
RESET: R32.2, U1.18 (PF6/~RESET)
SPI_MISO: J5.12, U1.27 (PA5/MISO), U7.2 (SO/SIO1)
SPI_MOSI: J5.11, U1.26 (PA4/MOSI), U2.14 (SER), U3.4 (SDI), U7.5 (SI/SIO0)
SPI_SCK: J5.9, U1.28 (PA6/SCK), U2.11 (SRCLK), U3.3 (SCK), U7.6 (SCK), U9.11 (SRCLK)
SRAM_CS: R33.2, U1.22 (PA0), U7.1 (~CS)
SR_CHAIN: U2.9 (Q7'), U9.14 (SER)
SR_CHAIN2: J5.15, U9.9 (Q7')
SR_OE: J5.14, R12.2, U1.23 (PA1), U2.13 (~OE), U9.13 (~OE)
SR_RCLK: J5.13, U1.1 (PA7), U2.12 (RCLK), U9.12 (RCLK)
SW_NODE: D2.2 (A), L1.2, U4.1 (SW)
U2_Q1: R43.1, U2.1 (Q1)
U6A_OUT: R24.1, U6.1 (OUTA)
U6B_OUT: U6.6 (-B), U6.7 (OUTB)
U9_Q0: R44.1, U9.15 (Q0)
UPDI: J3.1, U1.19 (PF7/UPDI)
USB_DM: J2.A7 (D-), J2.B7 (D-), U1.3 (DM)
USB_DP: J2.A6 (D+), J2.B6 (D+), U1.4 (DP)
VBOOST: C9.1, C11.1, D2.1 (K), Q2.2 (C), R34.1, U6.8 (V+)
VBUS: F1.1, J2.A4 (VBUS), J2.A9 (VBUS), J2.B4 (VBUS), J2.B9 (VBUS)
VCC7_EN: Q7.1 (G), R42.2, U9.7 (Q7)
VCC28_EN: Q6.1 (G), R41.2, U9.6 (Q6)
VCC_SKT: C2.1, C3.1, C16.1, J5.3, L1.1, Q6.2 (S), Q7.2 (S), R14.1, R41.1, R42.1, SW1.2, U4.5 (VIN)
VPP: C4.1, C5.1, C10.1, J1.2, J5.1, Q3.3 (E), R16.1, R25.2, R26.1, R28.1
VPP_SENSE: R16.2, R17.1, U1.7 (PD1/AIN1)
VSYS: C1.1, C13.1, C15.1, C19.1, J3.2, J4.3, J4.6, J5.5, R12.1, R15.1, R32.1, R33.1, SW1.1, U1.14 (VDD), U1.20 (VDD), U2.10 (~MR), U2.16 (VCC), U3.1 (VDD), U3.6 (~SHDN), U7.3 (SIO2), U7.7 (~HOLD), U7.8 (VCC), U9.10 (~MR), U9.16 (VCC)
VUSB: C14.1, J4.4, U1.2 (VUSB)
ZIF1: J1.1, R20.1
ZIF3: J1.3, R2.2
ZIF4: J1.4, U2.15 (Q0)
ZIF5: J1.5, U2.3 (Q3)
ZIF6: J1.6, U2.2 (Q2)
ZIF7: J1.7, Q7.3 (D), R43.2
ZIF8: J1.8, R3.2
ZIF9: J1.9, R4.2
ZIF10: J1.10, Q1.3 (D), R5.2
ZIF11: J1.11, R6.2
ZIF12: J1.12, Q4.3 (D), R44.2
ZIF13: J1.13, U9.1 (Q1)
ZIF14: J1.14, U9.2 (Q2)
ZIF15: J1.15, R45.2
ZIF16: J1.16, R46.1
ZIF17: J1.17, R7.2
ZIF18: J1.18, R8.2
ZIF19: J1.19, R1.2
ZIF20: J1.20, R9.2
ZIF21: J1.21, Q5.3 (D), R21.1
ZIF22: J1.22, R22.1
ZIF23: J1.23, R23.1
ZIF24: J1.24, U2.5 (Q5)
ZIF25: J1.25, U2.4 (Q4)
ZIF26: J1.26, R10.2
ZIF27: J1.27, U2.7 (Q7)
ZIF28: J1.28, Q6.3 (D), R47.1

Notes on the sheet:
J48 GAL / PAL Programmer (AVR16DU28) - Rev I: J5 expansion header
Connectivity is by net label on each pin stub. Footprints are not assigned. Generated from the Rev I netlist; run ERC after opening.
ZIF-28 switching (new in Rev H): U9 595 drives SCLK/SDIN/STB, BOOST_EN and the GND/VCC switches. All switches off at reset.
Logic supply select (new in Rev G): VSYS = 5 V or 3.3 V
J4 5V position: shunts 1-3 + 2-4 -> VSYS = +5V, VUSB from U1's internal USB regulator (USBVREG = 1). J4 3V3 position: shunts 3-5 + 4-6 -> VSYS = +3V3, VUSB tied to VDD; firmware writes SYSCFG.VUSBCTRL.USBVREG = 0. Move shunts only with USB unplugged; both on the same side. Firmware reads VDD via th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
