Monotoba/j48-gal-programmer/(commit log)

2026-10-18 Initial commit: J48 GAL / PAL Programmer, hardware Rev H
    Rev H schematic (SVG, PDF, KiCad), drawing and schematic generators with
    a netlist check, the ZIF-28 plan, README, clean-room policy and the story
    behind the name.
    Claude-Session: https://claude.ai/code/session_01JnSUixWDwegCziKEySiVmX
    [J48_RevH.kicad_sch, J48_RevH_ZIF28_Plan.xlsx]
2026-10-18 Add ZIF-28 pin map drawing for Rev H
    One socket drawing per device group (including the 26CV12/26V12) with the
    chip overlaid head-aligned, plus a table of every ZIF pin's role per device,
    its Rev H connection and the GND/VCC switch used for each chip size.
    The generator runs as part of build.sh.
    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
2026-10-18 Add clean-room spec: JEDEC file format and GAL16V8 (first draft)
    jedec.md covers the fields Wingman needs and the fuse and transmission
    checksums. 16v8.md covers the device, its QF2194 fuse map, programming-mode
    pins mapped to the J48's ZIF-28 and Rev H nets, the row map and ACW order,
    read/write/erase sequences, and voltages and pulse widths per algorithm.
    Every fact is cited; unsourced details are listed as open questions.
    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
2026-10-18 Rev I: add J5 expansion header for adapter boards
    J5 (2x8) brings out VPP, VCC_SKT, VSYS, +5V, the SPI bus, the 595 latch
    and output enable, and the end of the on-board 595 chain (U9 Q7', now
    SR_CHAIN2). Adapters extend the chain with 74HC595s for outputs, read back
    through 3-state 74HC589s on MISO, and identify themselves with an SPI EEPROM,
    so they need no MCU pins. docs/expansion.md documents the header and rules.
    The reference KiCad schematic and drawing move to Rev I; the netlist check
    passes on all 83 nets.
    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
    [J48_RevH.kicad_sch, J48_RevI.kicad_sch]
2026-10-19 Fix U1 pin numbers: use the SPDIP/SSOP-28 pinout
    The reference schematic's AVR16DU28 symbol carried the VQFN-28 column of the
    I/O multiplexing table instead of the SPDIP/SSOP-28 pinout, so every U1 pin
    number was wrong. Pin numbers now follow DS40002576 section 2.4 (identical in
    DS40002548 section 2.1 for the AVR64DU28), checked by script against the
    datasheet text for all 28 pins. Pin positions are unchanged, so the drawing
    and labels are unaffected.
    Adds hardware/kicad/GALProg.kicad_sym with corrected AVR16DU28 and AVR64DU28
    symbols for updating existing schematics in place.
    Claude-Session: https://claude.ai/code/session_01JnSUixWDw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
    [J48_RevI.kicad_sch]
